benricket/pitch-yaw-scanner/(commit log)

2025-09-23 Fix servos to reasonable rotation speed
    [servo_sweep.ino]
2025-09-25 Implement different modes for servo sweep
2025-09-26 Remove old servo test code
2025-09-26 Add report and misc project materials
